vinayshanbhag/esp32_precision_counter_pulse_generator/schematic.png

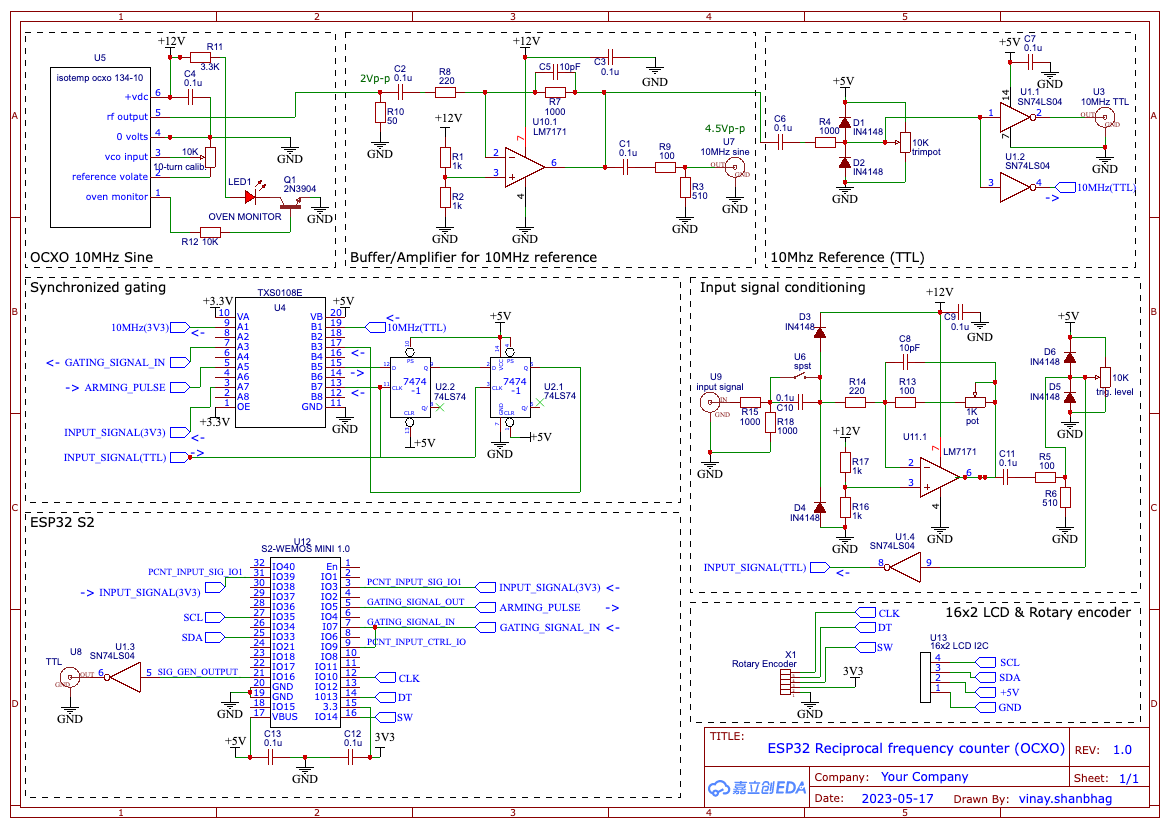
schematic.png
