vinayshanbhag/esp32_precision_counter_pulse_generator/ESP32_PrecisionReciprocalCounter_Generator.ino

/* Frequency Counter and square wave generator. Reciprocal counter with 8-9 digit precision
   Vinay Shanbhag

   Components:
    - Wemos (LOLIN) S2 mini
    - Dual D flip flop 74LVT74 (or 74LS74 with TTL level shifter TXS0108E)
    - rotary encoder (KY 040) for setting square wave frequency
    - 16x2 LCD display

   Theory of operation:
   A gating signal is produced on GATING_SIGNAL_OUT pin on the ESP32 and is approximately 
   equal to the selected gate time (MIN_GATE_TIME x user selected gate_time_multiplier).
   The gating signal from the ESP32 is wired into the D-flip flops, to produce a pcnt control signal
   perfectly aligned with the input signal(f_in), such that counting is enabled from the first 
   rising edge of f_in to the first rising edge of f_in after the gate time.

                                        |‾‾‾‾‾‾‾|     |‾‾‾‾‾‾‾|
      GATING_SIGNAL_OUT (ESP32) >>------|D     Q|-----|D     Q|--|-->> GATING_SIGNAL_IN   (ESP32)
                           f_in >>---+--|>clk   |  +--|>clk   |  |-->> PCNT_INPUT_CTRL_IO (ESP32)
                                     |  |_______|  |  |_______|
                                     +-------------+---------------->> PCNT_INPUT_SIG_IO1 (ESP32)

   REFERENCE_SIGNAL_OUT (ESP32) >>---------------------------------->> PCNT_INPUT_SIG_IO0 (ESP32)                                                    

  The counter counts the pulses in f_in and an internal reference (20Mhz) during this time.
  The frequency of f_in is given by n_in/n_ref * f_ref where,
  n_in = number of pulses from input signal f_in during the gate time
  n_ref = number of pulses from reference signal during the gate time
  f_ref = internal reference frequency.

  Compared to a direct counter, this method gives 8 digit resolution at all frequencies in 1s gate time. 
  
  Internal reference frequency of approximately 10Mhz is generated using ESP32 RMT.      
  Exact value of this frequency must be measured with a calibrated meter and entered in reference variable.
  2 PCNT counters are used - 
  - counter 0 counts the internal reference connected to PCNT_INPUT_SIG_IO0
  - counter 1 counts the input signal connected to PCNT_INPUT_SIG_IO1
  Both counters are set to count up when GATING_SIGNAL_IN is high.
  When GATING_SIGNAL_IN is low, counting is paused, frequency is calculated and the counters are reset.
  The counters are 16bit hence cannot go beyond 32767. noverflow0 and noverflow1, count the overflows on both counters.
  The total count for a counter is given by noverflow*PCNT_H_LIM_VAL + count. 
  PCNT_H_LIM_VAL is set to 20000(doesn't seem to work well at higher values)

  Rotary encoder controls the output frequency in discrete steps. 
                            GND >>---------------------------------->> GND (ESP32)
                            +   >>---------------------------------->> 3V3 (ESP32)
                            SW  >>---------------------------------->> GPIO37 (ESP32)
                            DT  >>---------------------------------->> GPIO33 (ESP32) 
                            CLK >>---------------------------------->> GPIO35 (ESP32)    
*/
#include <stdio.h>
#include "driver/pcnt.h"
#include "soc/pcnt_reg.h"
#include "soc/pcnt_struct.h"
#include "esp_timer.h"
#include <Wire.h>
#include <LiquidCrystal_PCF8574.h>
#include "AiEsp32RotaryEncoder.h"

// signal generator params {clock multiplier, on/off duration, nominal freq, calibrated freq value} 
float params[348][4] = {{247, 32393, 5, 4.9999829},
 {204, 32684, 6, 6.0000004},
 {201, 28433, 7, 6.9999978},
 {153, 32684, 8, 8.0000005},
 {136, 32684, 9, 9.0000006},
 {203, 19707, 10, 10.000002},
 {120, 30307, 11, 10.999994},
 {136, 24513, 12, 12.000001},
 {141, 21825, 13, 12.999998},
 {145, 19707, 14, 14.000003},
 {97, 27495, 15, 14.999998},
 {102, 24513, 16, 16.000001},
 {96, 24513, 17, 17.000001},
 {68, 32684, 18, 18.000001},
 {129, 16322, 19, 18.999998},
 {103, 19420, 20, 20.000009},
 {145, 13138, 21, 21.000004},
 {60, 30307, 22, 21.999988},
 {71, 24498, 23, 22.999991},
 {68, 24513, 24, 24.000002},
 {117, 13677, 25, 24.999996},
 {173, 8894, 26, 26.000004},
 {47, 31525, 27, 26.999996},
 {81, 17639, 28, 27.999977},
 {70, 19707, 29, 29.000006},
 {203, 6569, 30, 30.000006},
 {54, 23898, 31, 30.999974},
 {51, 24513, 32, 32.000002},
 {40, 30307, 33, 32.999982},
 {48, 24513, 34, 34.000002},
 {58, 19707, 35, 35.000007},
 {34, 32684, 36, 36.000002},
 {143, 7561, 37, 36.99997},
 {129, 8161, 38, 37.999997},
 {45, 22795, 39, 38.999994},
 {103, 9710, 40, 40.000019},
 {49, 19913, 41, 41.000002},
 {145, 6569, 42, 42.000009},
 {38, 24483, 43, 42.999996},
 {30, 30307, 44, 43.999976},
 {39, 22795, 45, 44.999993},
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


LiquidCrystal_PCF8574 lcd(0x27);
byte custom[3][8] = {
{ B11100,// gate on
  B11000,
  B10000,
  B00000,
  B00000,
  B00000,
  B00000,
  B00000},
{ B00000,//out
  B00000,
  B00000,
  B01110,
  B01010,
  B11011,
  B00000,
  B00000},
{ B10100,//Hz
  B10111,
  B11101,
  B10110,
  B10111,
  B00000,
  B00000,
  B00000}};                  

#define PCNT_H_LIM_VAL            20000       // counter overflow limit. max 32767, but higher values don't seem to work reliably

#define PCNT_TEST_UNIT0           PCNT_UNIT_0 // counter 0 counts reference clock pulses
#define PCNT_INPUT_SIG_IO0        GPIO_NUM_39 // counter 0 input (tied to REFERENCE_SIGNAL_OUT pin)
#define PCNT_INPUT_CTRL_IO        GPIO_NUM_9  // counter input control (high => count, low => stop counting)
#define PCNT_TEST_UNIT1           PCNT_UNIT_1 // counter 1 counts input signal transitions
#define PCNT_INPUT_SIG_IO1        GPIO_NUM_3  // counter 1 input (input signal connected here. 3V3 level only)
#define GATING_SIGNAL_IN          GPIO_NUM_7  // gating signal input from D flipflop. edges are aligned with input signal
#define GATING_SIGNAL_OUT         GPIO_NUM_5  // raw gating signal ~1s
#define REFERENCE_SIGNAL_OUT      GPIO_NUM_40 // ~10Mhz reference signal generated using ESP32 RMT
#define MIN_GATE_TIME             1000

#define SDA_PIN GPIO_NUM_33 // default SDA. change here if needed
#define SCL_PIN GPIO_NUM_35 // default SCL. change here if needed

#define ROTARY_ENCODER_A_PIN      GPIO_NUM_13 // DT pin on rotary encoder
#define ROTARY_ENCODER_B_PIN      GPIO_NUM_10 // CLK pin on rotary encoder
#define ROTARY_ENCODER_BUTTON_PIN GPIO_NUM_14 // SW on rotary encoder (push) 
#define ROTARY_ENCODER_VCC_PIN    -1          // tied to 3V3
#define OUTPUT_PIN                GPIO_NUM_16 // Signal generator output
#define ROTARY_ENCODER_STEPS      4

RTC_DATA_ATTR int encoderValue = 185; // default to index 185 in the lookup - 1KHz 
RTC_DATA_ATTR int set_duty = 50; // default to 50 
AiEsp32RotaryEncoder rotaryEncoder = AiEsp32RotaryEncoder(ROTARY_ENCODER_A_PIN, ROTARY_ENCODER_B_PIN, ROTARY_ENCODER_BUTTON_PIN, ROTARY_ENCODER_VCC_PIN, ROTARY_ENCODER_STEPS);

int gate_time_multiplier=1000;

//xQueueHandle pcnt_evt_queue;  /*A queue to handle pulse counter event*/

rmt_data_t bit_data[2];
rmt_obj_t* rmt_send = NULL;

rmt_data_t freq_gen_bit_data[2];
rmt_obj_t* freq_gen_rmt_send = NULL;

typedef struct {
    int unit;        /*pulse counter unit*/
    uint32_t status; /*pulse counter internal status*/
} pcnt_evt_t;

typedef struct {
    uint32_t count0;
    uint32_t noverflow0;
    uint32_t count1;
    uint32_t noverflow1; 
} reading_t;

reading_t reading;

uint32_t noverflow0 = 0;
uint32_t noverflow1 = 0;
int16_t  count0     = 0;
int16_t  count1     = 0;
float    reference  = 10001305.4; // Actual value measured on a calibrated HP5316B. measure the actual reference frequency on a calibrated meter and enter here.

bool last = false;
bool ready = false;

esp_timer_create_args_t timer_args;
esp_timer_handle_t timer;

// pcnt_evt_t evt;
// portBASE_TYPE res;

char display_line1[16]={'*',' ','i','n','i','t','i','a','l','i','z','i','n','g',' ','*'};
char display_line2[16]={'.','.','.','.','.','.','.','.','.','.','.','.','.','.','.','.'};

/* Create a formatted display string to be displayed on 1602 LCD
*/
void create_display_string(char* buf, float f, int duty=-1){
  char unit =' ';
  if (f>1000000){
    f /=1000000;
    unit = 'M';
  } else if (f > 1000){
    f/=1000;
    unit = 'K';
  } else {
    unit = ' ';
  }
  int precision = 8-int(log10(f)+1);
  precision = precision<0?0:precision;
  if (duty == -1){
    sprintf(buf, "%8.*f%c\03    ",precision,f,unit);
  } else {
    sprintf(buf, "%8.*f%c\03 %d%%",precision,f,unit,duty);  
  }
}

/* When rotary encoder push button is clicked. change the duty cycle and display on LCD
   Cycle through 10,20,30,40,50,60,70,80,90% duty cycle. Initial value is 50%
   Duty cycle remain at 50% if the paramters do not allow change in duty cycle
*/
void rotary_onButtonClick()
{ 
  encoderValue = rotaryEncoder.readEncoder(); //get encoder value
  
  float t_dur = params[encoderValue][1]; // get duration from lookup
  int duty = 50; // actual duty cycle
  Serial.print("button pressed ");
  if (t_dur < 18000 && t_dur > 40){ // if duty cycle can be changed, increment in steps of 10, between 10 and 90
    if (set_duty < 90){
      set_duty += 10;
    } else {
      set_duty = 10;
    }
    duty = set_duty;
  } else { // duty cycle cannot be applied reliably for this frequency, set to default 50%
    duty = 50;
  }

  float t_on = (t_dur/100)*2*duty; // compute on time
  float t_off = 2*t_dur - int(t_on); // off time = total time - on time
  bool stat = rmtDeinit(freq_gen_rmt_send);  // deinit rmt
  //Serial.printf("rmtDeinit: %d\n", stat);
  if ((freq_gen_rmt_send = rmtInit(OUTPUT_PIN, RMT_TX_MODE, RMT_MEM_64)) == NULL)
  {
      //Serial.println("init sender1 failed\n");
  }
  
  float realTick1 = rmtSetTick(freq_gen_rmt_send, 12.5*params[encoderValue][0]); // set clock per lookup
  // Send the data

  for (int i=0; i < 2; i++){ // set on and off times
    freq_gen_bit_data[i].level0=1;
    freq_gen_bit_data[i].duration0=int(t_on);
    freq_gen_bit_data[i].level1=0;
    freq_gen_bit_data[i].duration1=int(t_off);
  }
  Serial.printf("Index: %d, dur: %d, duty: %d, d0: %d, d1: %d, freq: %0.3f\n",encoderValue, int(t_dur), duty, int(t_on), int(t_off), params[encoderValue][3]);    
  rmtLoop(freq_gen_rmt_send, freq_gen_bit_data, 2);// send pulses
  //int d = 8-int(log10(params[encoderValue][3])+1);
  //d = d<0?0:d;
  //sprintf(display_line2, "%8.*f \03 %d%%",d,params[encoderValue][3],duty);
  create_display_string(display_line2, params[encoderValue][3], duty);
  lcd.setCursor(1, 1);      
  lcd.print(display_line2);
  lcd.setCursor(0, 1);   
  lcd.print("\02");
}


/* Rotaty encoder interrup service routine
*/
void IRAM_ATTR readEncoderISR()
{
  rotaryEncoder.readEncoder_ISR();
}

static void timer_callback(void* arg);

/* interrupt handler called when the gating signal (from the D flip flops) falls
 */
void ARDUINO_ISR_ATTR isr() {
  // Pause counting
  pcnt_counter_pause(PCNT_TEST_UNIT0);
  pcnt_counter_pause(PCNT_TEST_UNIT1);
  // retrieve counter values
  pcnt_get_counter_value(PCNT_TEST_UNIT0, &count0);
  pcnt_get_counter_value(PCNT_TEST_UNIT1, &count1);
  // save count and overflow values
  reading.count0 = count0;
  reading.count1 = count1;
  reading.noverflow0 = noverflow0;
  reading.noverflow1 = noverflow1;
  
  // reset overflow variable to zero
  noverflow0=0;
  noverflow1=0;
  // clear the counters
  pcnt_counter_clear(PCNT_TEST_UNIT0);
  pcnt_counter_clear(PCNT_TEST_UNIT1);
  // resume (counting will resume when control signal is high)
  pcnt_counter_resume(PCNT_TEST_UNIT0);
  pcnt_counter_resume(PCNT_TEST_UNIT1);
  ready = true;
}
#include <driver/rmt.h>

/* Start a reference signal at specified pin 
 */
void start_ref_clock(gpio_num_t pin, uint32_t clk_mult, uint32_t cycles_on, uint32_t cycles_off){  
  if ((rmt_send = rmtInit(pin, RMT_TX_MODE, RMT_MEM_64)) == NULL)
  {
      Serial.println("init sender failed\n");
  }
  float realTick = rmtSetTick(rmt_send, 12.5*clk_mult);
  // Send the data
  for (int i=0; i < 2; i++){
    bit_data[i].level0=1;
    bit_data[i].duration0=cycles_on;
    bit_data[i].level1=0;
    bit_data[i].duration1=cycles_off;
  }
  rmtLoop(rmt_send, bit_data, 2);
  Serial.printf("%0.0fMHz reference signal at pin %d\n", 1000/(12.5*clk_mult*(cycles_on+cycles_off)), pin);
}

/* Start a timer to create a gating signal at GATING_SIGNAL_OUT
   Period is set by MIN_GATE_TIME x gate_time_multiplier
 */
void start_gating_timer(){
  timer_args.callback = timer_callback;
  
  esp_timer_create(&timer_args, &timer);
  ESP_ERROR_CHECK(esp_timer_start_once(timer, MIN_GATE_TIME*gate_time_multiplier));
  gpio_pad_select_gpio(GATING_SIGNAL_OUT);                              
  gpio_set_direction(GATING_SIGNAL_OUT, GPIO_MODE_OUTPUT);
}

/* Timer callback for gating signal. Toggles the GATING_SIGNAL_OUT pin high/low
*/
static void timer_callback(void* arg)
{
    last = !last;
    gpio_set_level(GATING_SIGNAL_OUT, last);
    ESP_ERROR_CHECK(esp_timer_start_once(timer, MIN_GATE_TIME*gate_time_multiplier+random(500)));
}

/* Interrrupt handler for PCNT events. In this case only looking for event when the counter(s) overflow
   When there is an overflow increment the corresponding overflow variable.
*/
void IRAM_ATTR pcnt_intr_handler(void* arg)
{
    uint32_t intr_status = PCNT.int_st.val;
    int i;
    // pcnt_evt_t evt;
    portBASE_TYPE HPTaskAwoken = pdFALSE;
    for(i = 0; i < PCNT_UNIT_MAX; i++) {
        if(intr_status & (BIT(i))) {
            // evt.unit = i;
            // evt.status = PCNT.status_unit[i].val;
            PCNT.int_clr.val = BIT(i);
            /*H LIM EVT*/
            if((i==0) && PCNT.status_unit[i].cnt_thr_h_lim_lat_un) { // looked up from header files, does not match the ESP documentation
                noverflow0++;
            }
            if((i==1) && PCNT.status_unit[i].cnt_thr_h_lim_lat_un) { // looked up from header files, does not match the ESP documentation
                noverflow1++;
            }
            // xQueueSendFromISR(pcnt_evt_queue, &evt, &HPTaskAwoken);
            // if(HPTaskAwoken == pdTRUE) {
            //     portYIELD_FROM_ISR();
            // }
        }
    }
}
/* Initialize a counter 
*/
static void init_counter(pcnt_unit_t unit, pcnt_channel_t channel, gpio_num_t signal_in, gpio_num_t control_in, void (*handler)(void *)){
  gpio_pad_select_gpio(signal_in);                              
  gpio_set_direction(signal_in, GPIO_MODE_INPUT);
  gpio_pad_select_gpio(control_in);                              
  gpio_set_direction(control_in, GPIO_MODE_INPUT);  
  pcnt_config_t pcnt_config = {};
  pcnt_config.pulse_gpio_num = signal_in;
  pcnt_config.ctrl_gpio_num = control_in;
  pcnt_config.channel = PCNT_CHANNEL_0;
  pcnt_config.unit = unit;
  pcnt_config.pos_mode = PCNT_COUNT_INC;
  pcnt_config.neg_mode = PCNT_COUNT_DIS;//keep the counter value      
  pcnt_config.lctrl_mode = PCNT_MODE_DISABLE;
  pcnt_config.hctrl_mode = PCNT_MODE_KEEP;      //when control signal is high,keep the primary counter mode
  pcnt_config.counter_h_lim = PCNT_H_LIM_VAL;
  pcnt_unit_config(&pcnt_config);
  pcnt_event_enable(unit, PCNT_EVT_H_LIM);
  pcnt_counter_pause(unit);
  pcnt_counter_clear(unit);
  pcnt_isr_register(handler, NULL, 0, NULL);
  pcnt_intr_enable(unit);
  pcnt_counter_resume(unit);
}

void setup()
{
    Serial.begin(115200);
    //while (!Serial);
    delay(500);
    Serial.printf("Begin\n");
    Wire.begin(SDA_PIN,SCL_PIN);
    Wire.beginTransmission(0x27);
    int result = Wire.endTransmission();
    Serial.print("Result: ");
    Serial.print(result);

    if (result == 0) {
      Serial.println(": LCD found.");
      lcd.begin(16, 2);  // initialize the lcd
      for (int i=0; i < 3; i++){
        lcd.createChar(i+1, custom[i]);
      }
      lcd.setBacklight(100);
      lcd.clear();
      lcd.setCursor(0, 0);      
      lcd.print(display_line1);
      lcd.setCursor(0, 1);      
      lcd.print(display_line2);
      delay(1000);
      lcd.clear();
      lcd.setCursor(0, 0);
      lcd.print("calibrated ref:");
      lcd.setCursor(0, 1); 
      sprintf(display_line2, "%10.1fHz", reference);    
      lcd.print(display_line2);
      delay(5000);
      lcd.clear();
    } else {
      Serial.println(": LCD not found.");
    }
    /*Init PCNT event queue */
    // pcnt_evt_queue = xQueueCreate(50, sizeof(pcnt_evt_t));   

    // Start reference clock
    start_ref_clock(REFERENCE_SIGNAL_OUT,1,3,5);   
     
    // Initialize reference counter
    init_counter(PCNT_TEST_UNIT0, PCNT_CHANNEL_0, PCNT_INPUT_SIG_IO0, PCNT_INPUT_CTRL_IO, pcnt_intr_handler);
    // Initialize input signal counter
    init_counter(PCNT_TEST_UNIT1, PCNT_CHANNEL_0, PCNT_INPUT_SIG_IO1, PCNT_INPUT_CTRL_IO, pcnt_intr_handler);

    // start gating timer
    start_gating_timer();

    // Configure gating signal input
    gpio_pad_select_gpio(GATING_SIGNAL_IN);                              
    gpio_set_direction(GATING_SIGNAL_IN, GPIO_MODE_INPUT);
    // Attach an interrupt that fires when gating signal falls 
    attachInterrupt(digitalPinToInterrupt(GATING_SIGNAL_IN), isr, FALLING);

    rotaryEncoder.begin();
    rotaryEncoder.setup(readEncoderISR);
    //set boundaries and if values should cycle or not
    //in this example we will set possible values between 0 and 1000;
    bool circleValues = false;
    rotaryEncoder.setBoundaries(0, 347, circleValues); //minValue, maxValue, circleValues true|false (when max go to min and vice versa)
  
    rotaryEncoder.disableAcceleration(); //acceleration is now enabled by default - disable if you dont need it
    //rotaryEncoder.setAcceleration(250); //or set the value - larger number = more accelearation; 0 or 1 means disabled acceleration

    rotaryEncoder.setEncoderValue(encoderValue);// set encoder default to index 185 - 1KHz. If waking from sleep. set to last value before sleep
    encoderValue = rotaryEncoder.readEncoder();
    Serial.printf("setup - Index: %d, dur: %d, duty: %d, freq: %0.3f\n",encoderValue, int(params[encoderValue][1]), set_duty, params[encoderValue][3]);

}


void loop(){
  // if there is a new reading, display new frequency
  if (ready){
    int n_ref = ((reading.noverflow0*PCNT_H_LIM_VAL)+reading.count0);
    int n_sig = ((reading.noverflow1*PCNT_H_LIM_VAL)+reading.count1);

    float frequency = float(n_sig)/float(n_ref)*reference;
    int precision = 8 - int(log10(frequency)+1);//int(log10(n_ref)+1) - int(log10(frequency)+1);
    precision = precision<0?0:precision;
    if (frequency){
      //sprintf(display_line1, "%-8.*f \04", precision,frequency);
      create_display_string(display_line1,frequency);
      Serial.printf("Frequency: %0.*f Hz, Gate Time: %0.3fs\n", precision,frequency, gate_time_multiplier*MIN_GATE_TIME/1000000.0);
      //lcd.clear();
      lcd.setCursor(1, 0);      
      lcd.print(display_line1);
    }
    ready = false;
  }
  // flash the gate indicator on LCD to indicate counter is working
  bool gate_on = gpio_get_level(PCNT_INPUT_CTRL_IO);
  if (gate_on){
    lcd.setCursor(0, 0);   
    lcd.print("\01");
  } else {
    lcd.setCursor(0, 0);   
    lcd.print(" ");
  }
  // If rotary encoder changed, signal generator outputs new frequency and displays it on LCD 
  if (rotaryEncoder.encoderChanged()) // if encoder value changed
  {
    Serial.print("encoder changed ");
    encoderValue = rotaryEncoder.readEncoder(); // read encoder value
    float t_dur = params[encoderValue][1];
    int duty = 50;
    if (t_dur > 18000 || t_dur < 40){ // requested duty cycle cannot be applied reliably, default to 50
      duty = 50;
    } else {
      duty = set_duty;
    }
    float t_on = (t_dur/100)*2*duty;
    float t_off = 2*t_dur - int(t_on);    
    bool stat = rmtDeinit(freq_gen_rmt_send);
    //Serial.printf("rmtDeinit: %d\n", stat);
    if ((freq_gen_rmt_send = rmtInit(OUTPUT_PIN, RMT_TX_MODE, RMT_MEM_64)) == NULL)
    {
        //Serial.println("init sender1 failed\n");
    }
    float realTick1 = rmtSetTick(freq_gen_rmt_send, 12.5*params[encoderValue][0]);
    // Send the data
    for (int i=0; i < 2; i++){
      freq_gen_bit_data[i].level0=1;
      freq_gen_bit_data[i].duration0=int(t_on);
      freq_gen_bit_data[i].level1=0;
      freq_gen_bit_data[i].duration1=int(t_off);
    }
    Serial.printf("Index: %d, dur: %d, duty: %d, d0: %d, d1: %d, freq: %0.3f\n",encoderValue, int(t_dur), duty, int(t_on), int(t_off), params[encoderValue][3]);    
    rmtLoop(freq_gen_rmt_send, freq_gen_bit_data, 2);

    // int d = 8-int(log10(params[encoderValue][3])+1);
    // d = d<0?0:d;
    // sprintf(display_line2, "%8.*f \03 %d%%",d,params[encoderValue][3],duty);
    create_display_string(display_line2, params[encoderValue][3], duty);
    lcd.setCursor(1, 1);      
    lcd.print(display_line2);
    lcd.setCursor(0, 1);   
    lcd.print("\02");
  }
  // If rotary encoder was pushed. Update duty cycle (if possible) and display on LCD
  if (rotaryEncoder.isEncoderButtonClicked())
  {
    rotary_onButtonClick();
  } 

  delay(10);
}
